DuZhou08/can-monitor-system/docs/HARDWARE.md

# 硬件 (Hardware)

> v1.0 · 2026-10 · DuZhou

三节点硬件平台：**主机（STM32F407VET6）+ 从机 0（STM32F103C8T6）+ 从机 1（STM32F103C8T6）**，通过 **CAN 总线（125 kbps）** 互联。

**简体中文** | [English](HARDWARE.en.md)

- 引脚分配 → [`PINOUT.md`](PINOUT.md)
- CAN 协议 → [`PROTOCOL.md`](PROTOCOL.md)
- 原理图 → [`SCH_Schematic1_2026-10-07.pdf`](SCH_Schematic1_2026-10-07.pdf)

## 系统组成

- **主机**（STM32F407VET6）：ILI9341 320×240 TFT + HR2046 触摸（SPI2）、W25Q64 Flash（SPI1）、TJA1050
- **从机 0**（STM32F103C8T6）：光敏模块 + 热敏模块（ADC）、OLED（I2C）、TJA1050
- **从机 1**（STM32F103C8T6）：MPU6050（I2C）、OLED（I2C）、TJA1050
- 三节点经 **CAN 总线（125 kbps · 双绞 · 两端 120 Ω · 共地）** 互联

> 拓扑图见根目录 [`README.md`](../README.md) 的「系统架构」。

## 物料清单 (BOM)

### 主机 (master)
| 器件 | 型号 / 规格 | 数量 | 备注 |
| --- | --- | ---- | --- |
| 主控开发板 | STM32F407VET6 (168 MHz) | 1 | 最小系统板 |
| TFT 模块 | ILI9341 2.4" SPI (14P, SD 槽 + HR2046 触摸) | 1 | 320×240 |
| SPI Flash  | W25Q64 (64 Mbit) | 1 | 掉电保存阈值 |
| CAN 收发器 | TJA1050 模块（板载 120 Ω） | 1 | **5V 供电**  |
| 工作灯 | LED (低电平点亮) | 1 | 心跳指示 |

### 从机 0 (slave-sensors)
| 器件 | 型号 / 规格 | 数量 | 备注 |
| --- | --- | ---- | --- |
| 主控开发板 | STM32F103C8T6 (72 MHz) | 1 | BluePill 最小系统 |
| 光照传感器 | 光敏电阻模块 (GL5516) | 1 | AO 输出 → ADC |
| 温度传感器 | NTC 热敏电阻模块 | 1 | AO 输出 → ADC |
| OLED | SSD1306 0.96" 128×64 (I2C, 0x78) | 1 | 本地显示 |
| CAN 收发器 | TJA1050 模块（板载 120 Ω） | 1 | 5V 供电 |
| 工作灯 | 板载 LED (PC13, 低电平点亮) | 1 | 心跳指示 |

### 从机 1 (slave-mpu)
| 器件 | 型号 / 规格 | 数量 | 备注 |
| --- | --- | ---- | --- |
| 主控开发板 | STM32F103C8T6 (72 MHz) | 1 | BluePill 最小系统 |
| 六轴 IMU | MPU6050 (I2C, 0x68) | 1 | 加速度 + 陀螺仪 |
| OLED | SSD1306 0.96" 128×64 (I2C, 0x78) | 1 | 本地显示 |
| CAN 收发器 | TJA1050 模块（板载 120 Ω） | 1 | 5V 供电 |
| 工作灯 | 板载 LED (PC13, 低电平点亮) | 1 | 心跳指示 |

### 公共
| 器件 | 型号 / 规格 | 数量 | 备注 |
| --- | --- | ---- | --- |
| CAN 收发器 | TJA1050 模块（板载 120 Ω） | 3 | 三节点各一 |
| 终端电阻 | 120 Ω（模块板载） | 2 | 每块收发器模块自带 |
| 电源 | 5V / 3.3V | — | 三节点共地 |

## 接线

### CAN 总线
| 项 | 说明 |
| --- | --- |
| 速率 | 125 kbps (PSC 主机 56 / 从机 48) |
| 引脚 | PA11 = CAN_RX → TJA1050 RXD；PA12 = CAN_TX → TJA1050 TXD |
| 收发器 | TJA1050，VCC = 5V |
| 终端 | 总线**两端**各 120 Ω |
| 连线 | CANH / CANL **双绞**，三节点**共地** |

### 主机接线
| 外设 | 信号 | 引脚 |
| --- | --- | --- |
| ILI9341 | SCK / MOSI / MISO | PB13 / PB15 / PB14 |
| ILI9341 | CS / DC / BKL / RST | PB12 / PC5 / PB1 / PB0 |
| HR2046 (触摸) | CS / IRQ | PC6 / PC7 |
| W25Q64 | CS / SCK / MISO / MOSI | PA4 / PA5 / PA6 / PA7  |
| TJA1050 | RXD / TXD | PA11 / PA12 |
| 工作灯 | LED1 | PA1 |

### 从机 0 (slave-sensors) 接线
| 外设 | 信号 | 引脚 |
| --- | --- | --- |
| 光敏模块 | AO | PA0 (ADC1_IN0) |
| 热敏模块 | AO | PA1 (ADC1_IN1) |
| OLED | SCL / SDA | PB8 / PB9 |
| TJA1050  | RXD / TXD | PA11 / PA12 |
| 工作灯 | 板载 LED  | PC13 |

### 从机 1 (slave-mpu) 接线
| 外设 | 信号 | 引脚 |
| --- | --- | --- |
| MPU6050 | SCL / SDA | PB10 / PB11 |
| OLED | SCL / SDA | PB8 / PB9 |
| TJA1050 | RXD / TXD | PA11 / PA12 |
| 工作灯  | 板载 LED  | PC13 |

## 电源
- 三节点统一 **5V** 供电、**共地**
- **TJA1050 必须 5V**（3.3V 会导致从机掉线）
- 各开发板/MCU 用板载 LDO 转 3.3V

## 原理图

- 完整 PDF：[`SCH_Schematic1_2026-10-07.pdf`](SCH_Schematic1_2026-10-07.pdf)（嘉立创 EDA 导出）

### 主机 (master)

主机原理图

### 从机 0 (slave-sensors)

从机 0 原理图

### 从机 1 (slave-mpu)

从机 1 原理图

## 已知问题 / 备注
- **终端电阻**：模块板载 120 Ω，三节点实测为 **3×120 Ω = 40 Ω**（过终端）。总线 <1m、125 kbps 下可接受；规范做法是仅**两端**各 120 Ω。
- **TJA1050 供电**：早期 3.3V 供电导致从机频繁掉线；统一 **5V** 后 `ERR T/R = 0/0`。
- **温度标定**：NTC 为单点实测标定（26°C ↔ ADC 1750），非线性误差见 `PROTOCOL.md`。
