DuZhou08/can-monitor-system/docs/SCH_Schematic1_2026-10-07.pdf

+3.3V 20 VBAT 21 PC13 22 PC14 23 PC15 24 PA0 25 PA1 26 PA2 27 PA3 28 PA4 29 PA5 30 PA6 31 PA7 32 PB0 33 PB1 34 PB10 35 PB11 36 RESET 37 +3.3V 38 GND 39 GND 40

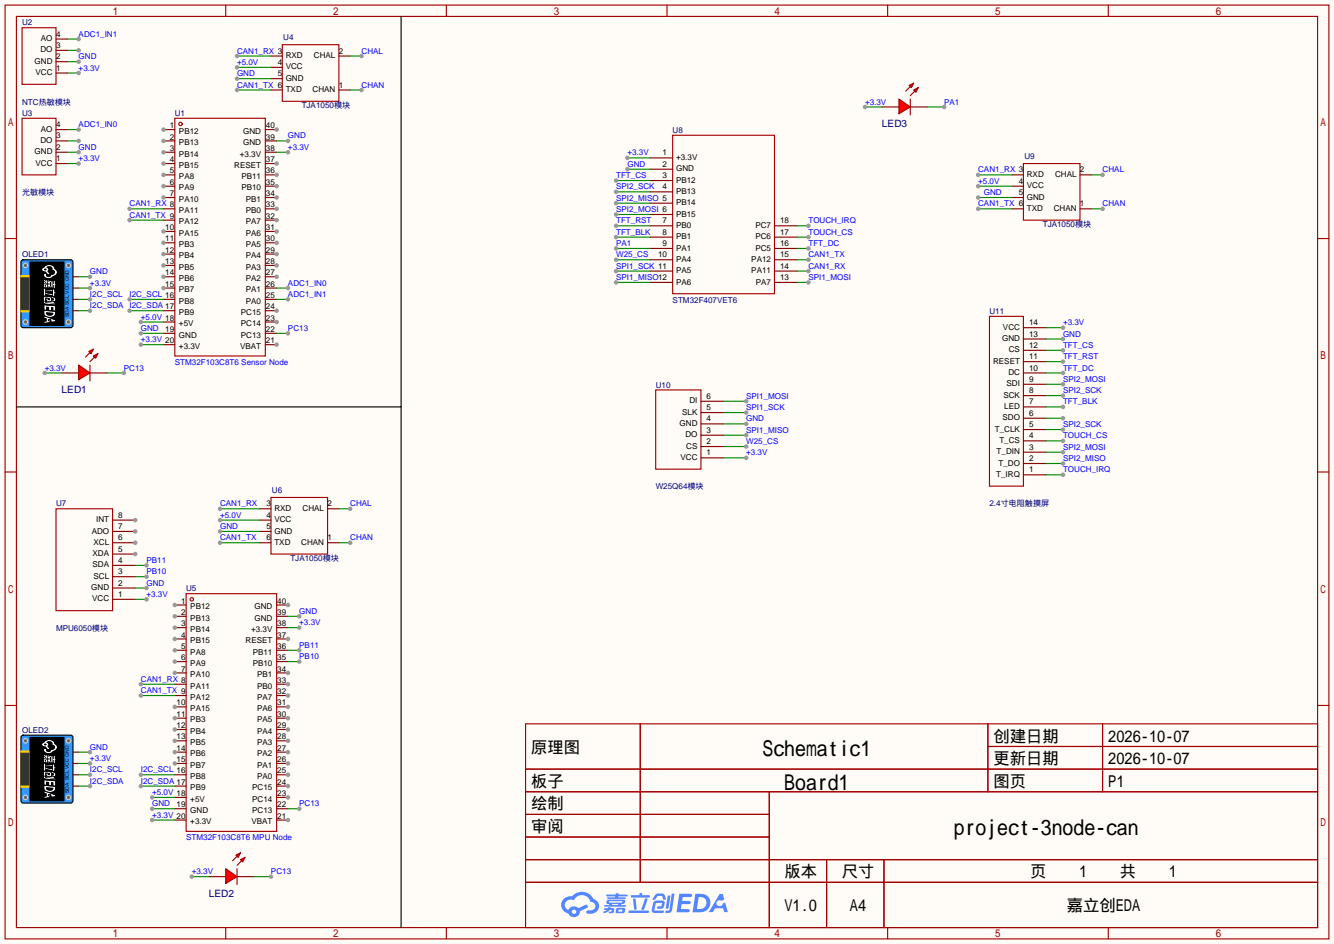
[picture p13: page 1]

GND VCC SCL SDA

原理图 | Schematic1 | 创建日期 | 2026-10-07

更新日期 | 2026-10-07

板子 | Board1 | 图页 | P1
绘制 | | project-3node-can
审阅

V1.0 | A4 | 嘉立创EDA
