DuZhou08/can-monitor-system/master/hardware/LED.c

#include "stm32f4xx.h"

void LED_Init(void)
{
	RCC_AHB1PeriphClockCmd(RCC_AHB1Periph_GPIOA, ENABLE);

	GPIO_InitTypeDef GPIO_InitStructure;
	GPIO_InitStructure.GPIO_Mode = GPIO_Mode_OUT;
	GPIO_InitStructure.GPIO_OType = GPIO_OType_PP;
	GPIO_InitStructure.GPIO_PuPd = GPIO_PuPd_NOPULL;
	GPIO_InitStructure.GPIO_Pin = GPIO_Pin_1;   
	GPIO_InitStructure.GPIO_Speed = GPIO_Speed_100MHz;
	GPIO_Init(GPIOA, &GPIO_InitStructure);

	GPIO_SetBits(GPIOA, GPIO_Pin_1);
}

void LED1_ON(void)
{
	GPIO_ResetBits(GPIOA, GPIO_Pin_1);
}

void LED1_OFF(void)
{
	GPIO_SetBits(GPIOA, GPIO_Pin_1);
}

void LED1_Turn(void)
{
	if (GPIO_ReadOutputDataBit(GPIOA, GPIO_Pin_1) == 0)
	{
		GPIO_SetBits(GPIOA, GPIO_Pin_1);
	}
	else
	{
		GPIO_ResetBits(GPIOA, GPIO_Pin_1);
	}
}
