DuZhou08/can-monitor-system/slave-mpu/app/MYApp.h

#ifndef __MYAPP_H
#define __MYAPP_H

#include "stm32f10x.h"

#include "FreeRTOS.h"
#include "task.h"

/*hardware function*/
#include "LED.h"
#include "OLED.h"
#include "MYCAN.h"
#include "MPU6050.h"
/*                 */

#include "semphr.h"

void FreeRTOS_Start(void);

#endif
