DuZhou08/can-monitor-system/slave-sensors/hardware/LED.c

#include "stm32f10x.h"
#include "LED.h"

#define Work_LED_TOGGLE()   GPIOC->ODR ^= GPIO_Pin_13

void LED_Init(void)
{
    RCC_APB2PeriphClockCmd(RCC_APB2Periph_GPIOC, ENABLE);

    GPIO_InitTypeDef GPIO_InitStructure;
    GPIO_InitStructure.GPIO_Pin = GPIO_Pin_13;
    GPIO_InitStructure.GPIO_Mode = GPIO_Mode_Out_PP;
    GPIO_InitStructure.GPIO_Speed = GPIO_Speed_50MHz;
    GPIO_Init(GPIOC, &GPIO_InitStructure);

    GPIO_SetBits(GPIOC, GPIO_Pin_13);
}

void Work_LED_On(void)
{
    GPIO_ResetBits(GPIOC, GPIO_Pin_13);
}

void Work_LED_Off(void)
{
    GPIO_SetBits(GPIOC, GPIO_Pin_13);
}

void Work_LED_Turn(void)
{
    Work_LED_TOGGLE();
}
