DuZhou08/can-monitor-system/(commit log)

2026-10-10 feat: 三节点 CAN 分布式监控平台
    Three MCU nodes networked over a CAN bus (125 kbps):
    - master STM32F407 + FreeRTOS + LVGL touch console
    (overview / node / diagnostics / settings UI, W25Q64 power-loss save)
    - slave-sensors STM32F103 light / temperature acquisition (ADC)
    - slave-mpu STM32F103 MPU6050 attitude acquisition
    Features:
    - Custom bidirectional CAN protocol (SET_PERIOD / PING + ACK)
    - Frame-loss stats / disconnect detection / bus diagnostics (TEC / REC / LEC)
    - Three EIDE projects + bilingual docs / schematics / hardware photos
2026-10-10 fix: 系统架构图改用 Mermaid 渲染
    Replace the ASCII architecture diagram with a Mermaid graph so it renders
    correctly on GitHub regardless of the viewer's CJK font width.
    - The ASCII box diagram was misaligned on GitHub: CJK glyphs are not exactly
    2x the monospace advance width, so the right box edges drifted.
    - Mermaid is rendered natively by GitHub as a vector graphic and is always aligned.
    - Applied to both README.md and README.en.md for consistency.
2026-10-10 docs: 新增三节点系统演示 GIF
    Add a real-device demo GIF to both READMEs.
    - docs/images/demo.gif (250x240, ~19.5s, 15fps, loops forever)
    - New "演示 / Demo" section placed after "界面展示 / UI Gallery"
    - Added to table of contents in both README.md and README.en.md
2026-10-13 ci: 新增 GitHub Actions 自动构建（三工程编译）
    Add a CI workflow that builds all three firmware projects with
    arm-none-eabi-gcc on every push, plus a build-status badge in the READMEs.
    - scripts/build.py: build an EIDE project straight from .eide/eide.yml
    (sources, defines, includes, linker script) - no VS Code required
    - .github/workflows/build.yml: install gcc-arm-none-eabi + python3-yaml,
    then build slave-sensors, slave-mpu and master
    - build badge added to README.md and README.en.md
2026-10-13 ci: 上传构建产物并新增静态徽章
    - scripts/build.py: also emit .hex and .bin via arm-none-eabi-objcopy
    - .github/workflows/build.yml: upload .elf/.hex/.bin as a downloadable artifact
    - README (zh + en): add License / C / STM32 / LVGL badges next to the build badge
2026-10-13 ci: tag 推送时自动创建 Release 并附加固件
