DuZhou08/can-monitor-system/(notices)

Notices in the files:
README.md:
License: MIT
